feastorg/bread-mechanical/slice-case/design/backplane/viz.scad

// SPDX-License-Identifier: GPL-3.0-or-later OR CERN-OHL-S-2.0
// Visual only: the backplane with a cased slice in every slot (case params by -D, as clash.scad).
include <../synth/case.scad>
use <backplane.scad>
backplane();
for (k = [0 : 3]) multmatrix([[0, 0, -1, k * 30.4], [0, 1, 0, 0], [1, 0, 0, 0]]) { tray(); lid(); panel(stop_gap); }
