feastorg/bread-mechanical/(commit log)

2026-05-20 Add SCAD enclosure files from BREADS, update README
    - nano.scad: Arduino Nano mechanical model
    - slice_case.scad: Slice enclosure design
    - README: describes repo purpose and contents
    [nano.scad, slice_case.scad]
2026-10-17 feat(slice-case): add parametric slice case and backplane part (#1)
    Add slice-case/: a data-driven OpenSCAD case for BREADS Slice boards
    (tray, lid and a sliding front panel) and a printed backplane part
    for Loaf_x004 gen1 and r3, meeting only through slot interface v1.1.
    Per-slice parameters are resolved from each slice's slice.yaml and
    .kicad_pcb into design/synth/resolved/, one line per section.
    partspec specs check the case for all resolved slices, the backplane
    part against real cases in every slot, and the print orientations;
    mutation sweeps check the checks. print/build.sh rebuilds every STL,
    since STLs are not tracked.
    A Slice_RLHT case and the backplane part were printed and fitte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
    [backplane.scad, case.scad, clash.scad, coupons.scad, panel.scad, print.scad, scenes.scad, viz.scad]
2026-10-18 feat(slice-case): add a snap-in plug for the Nano USB port (#2)
    usb_plug is a separate part that closes the USB port when no cable is
    in: a 1.2 cover on the outer wall face and two snap arms through the
    port at its E edges, whose hooks catch the inner wall face by 0.25.
    The arms stay clear of the Nano receptacle, which on the nano-b boards
    sits in the port 0.17 in from the outer face. One plug fits every Nano
    case; the tray is unchanged.
    New checks for both USB groups: the seated plug does not enter the
    tray or the board (including the receptacle), and pulled 0.3 out both
    hooks meet the wall more than 0.1 past the port edge. mutate.py takes
    an optional name filter and carries four plug muta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
    [case.scad, print.scad]
2026-11-13 docs: offer GPL-3.0-or-later or CERN-OHL-S-2.0 per file (#6)
    The README said CERN-OHL-S-2.0 while LICENSE held only the GPL-3.0
    text, and the CERN text was nowhere in the repo. The designs are now
    offered under either licence at the recipient's choice.
    - LICENSES/ holds both texts; LICENSE stays GPL-3.0 so GitHub keeps
    detecting a licence (layout from feastorg/bread-infra#11). The
    CERN-OHL-S-2.0 text is the copy bread-infra and nano-dev-boards
    already ship.
    - LICENSING.md explains the choice, and that a file whose SPDX header
    names a narrower licence (such as parts built on GPL-only libraries)
    is offered under that one only.
    - Every .scad, .py and .sh file carries
    "SPDX-License-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
    [backplane.scad, case.scad, clash.scad, coupons.scad, nano.scad, panel.scad, print.scad, scenes.scad]
2026-11-13 feat(sbc-case): add Pi cases and a 2020 extrusion mount (#7)
    Cases for the Raspberry Pi 4B, 3A+ and Zero 2 W that run a BREAD, built
    on SBC Case Builder's shell design (pinned, unmodified), plus:
    - a window in the lid roof over the GPIO header, so jumpers to the Loaf
    plug in with the lid on. Case Builder's gpio_opening "open" cuts only
    the side wall. The window keeps a 0.5 mm ring around each lid standoff,
    following its hex, which ends exactly at the pin field (x = 7.0).
    - an extrusion mount: an 8 mm plate under the case that the case's own
    four M2.5 x 16 screws pass through into heat-set inserts in the lid,
    held on 2020 by two M5 screws into T-nuts. The extrusion runs across
    the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
    [board_data.scad, sbc_case.scad]
2026-11-13 fix(sbc-case): keep the Zero 2 W lid wall whole; readable coupon (#8)
    On the Zero 2 W, Case Builder's hex roof pattern covers the whole roof,
    and the GPIO window leaves almost no roof beside the header-side wall
    (the pin field ends 0.4 mm from the board edge). Together they cut that
    wall into a row of free-standing posts. The Zero now has a solid roof
    with only the window; it runs cool at control loads.
    A new header-wall check asserts that wall is solid along its length,
    roof to rim, on every board. Putting the hex pattern back fails it on
    the Zero (lid-rpizero2w:header-wall), and the mutation sweep carries
    that case: 13 of 13 mutations caught. All 10 parts pass (13 checks per
    lid).
    The in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
    [board_data.scad, sbc_case.scad]
